reese-grimsley/ww-impedance-matching/ww-impedance-matching.brd

## EAGLE design ww-impedance-matching.brd (2021-09-02)

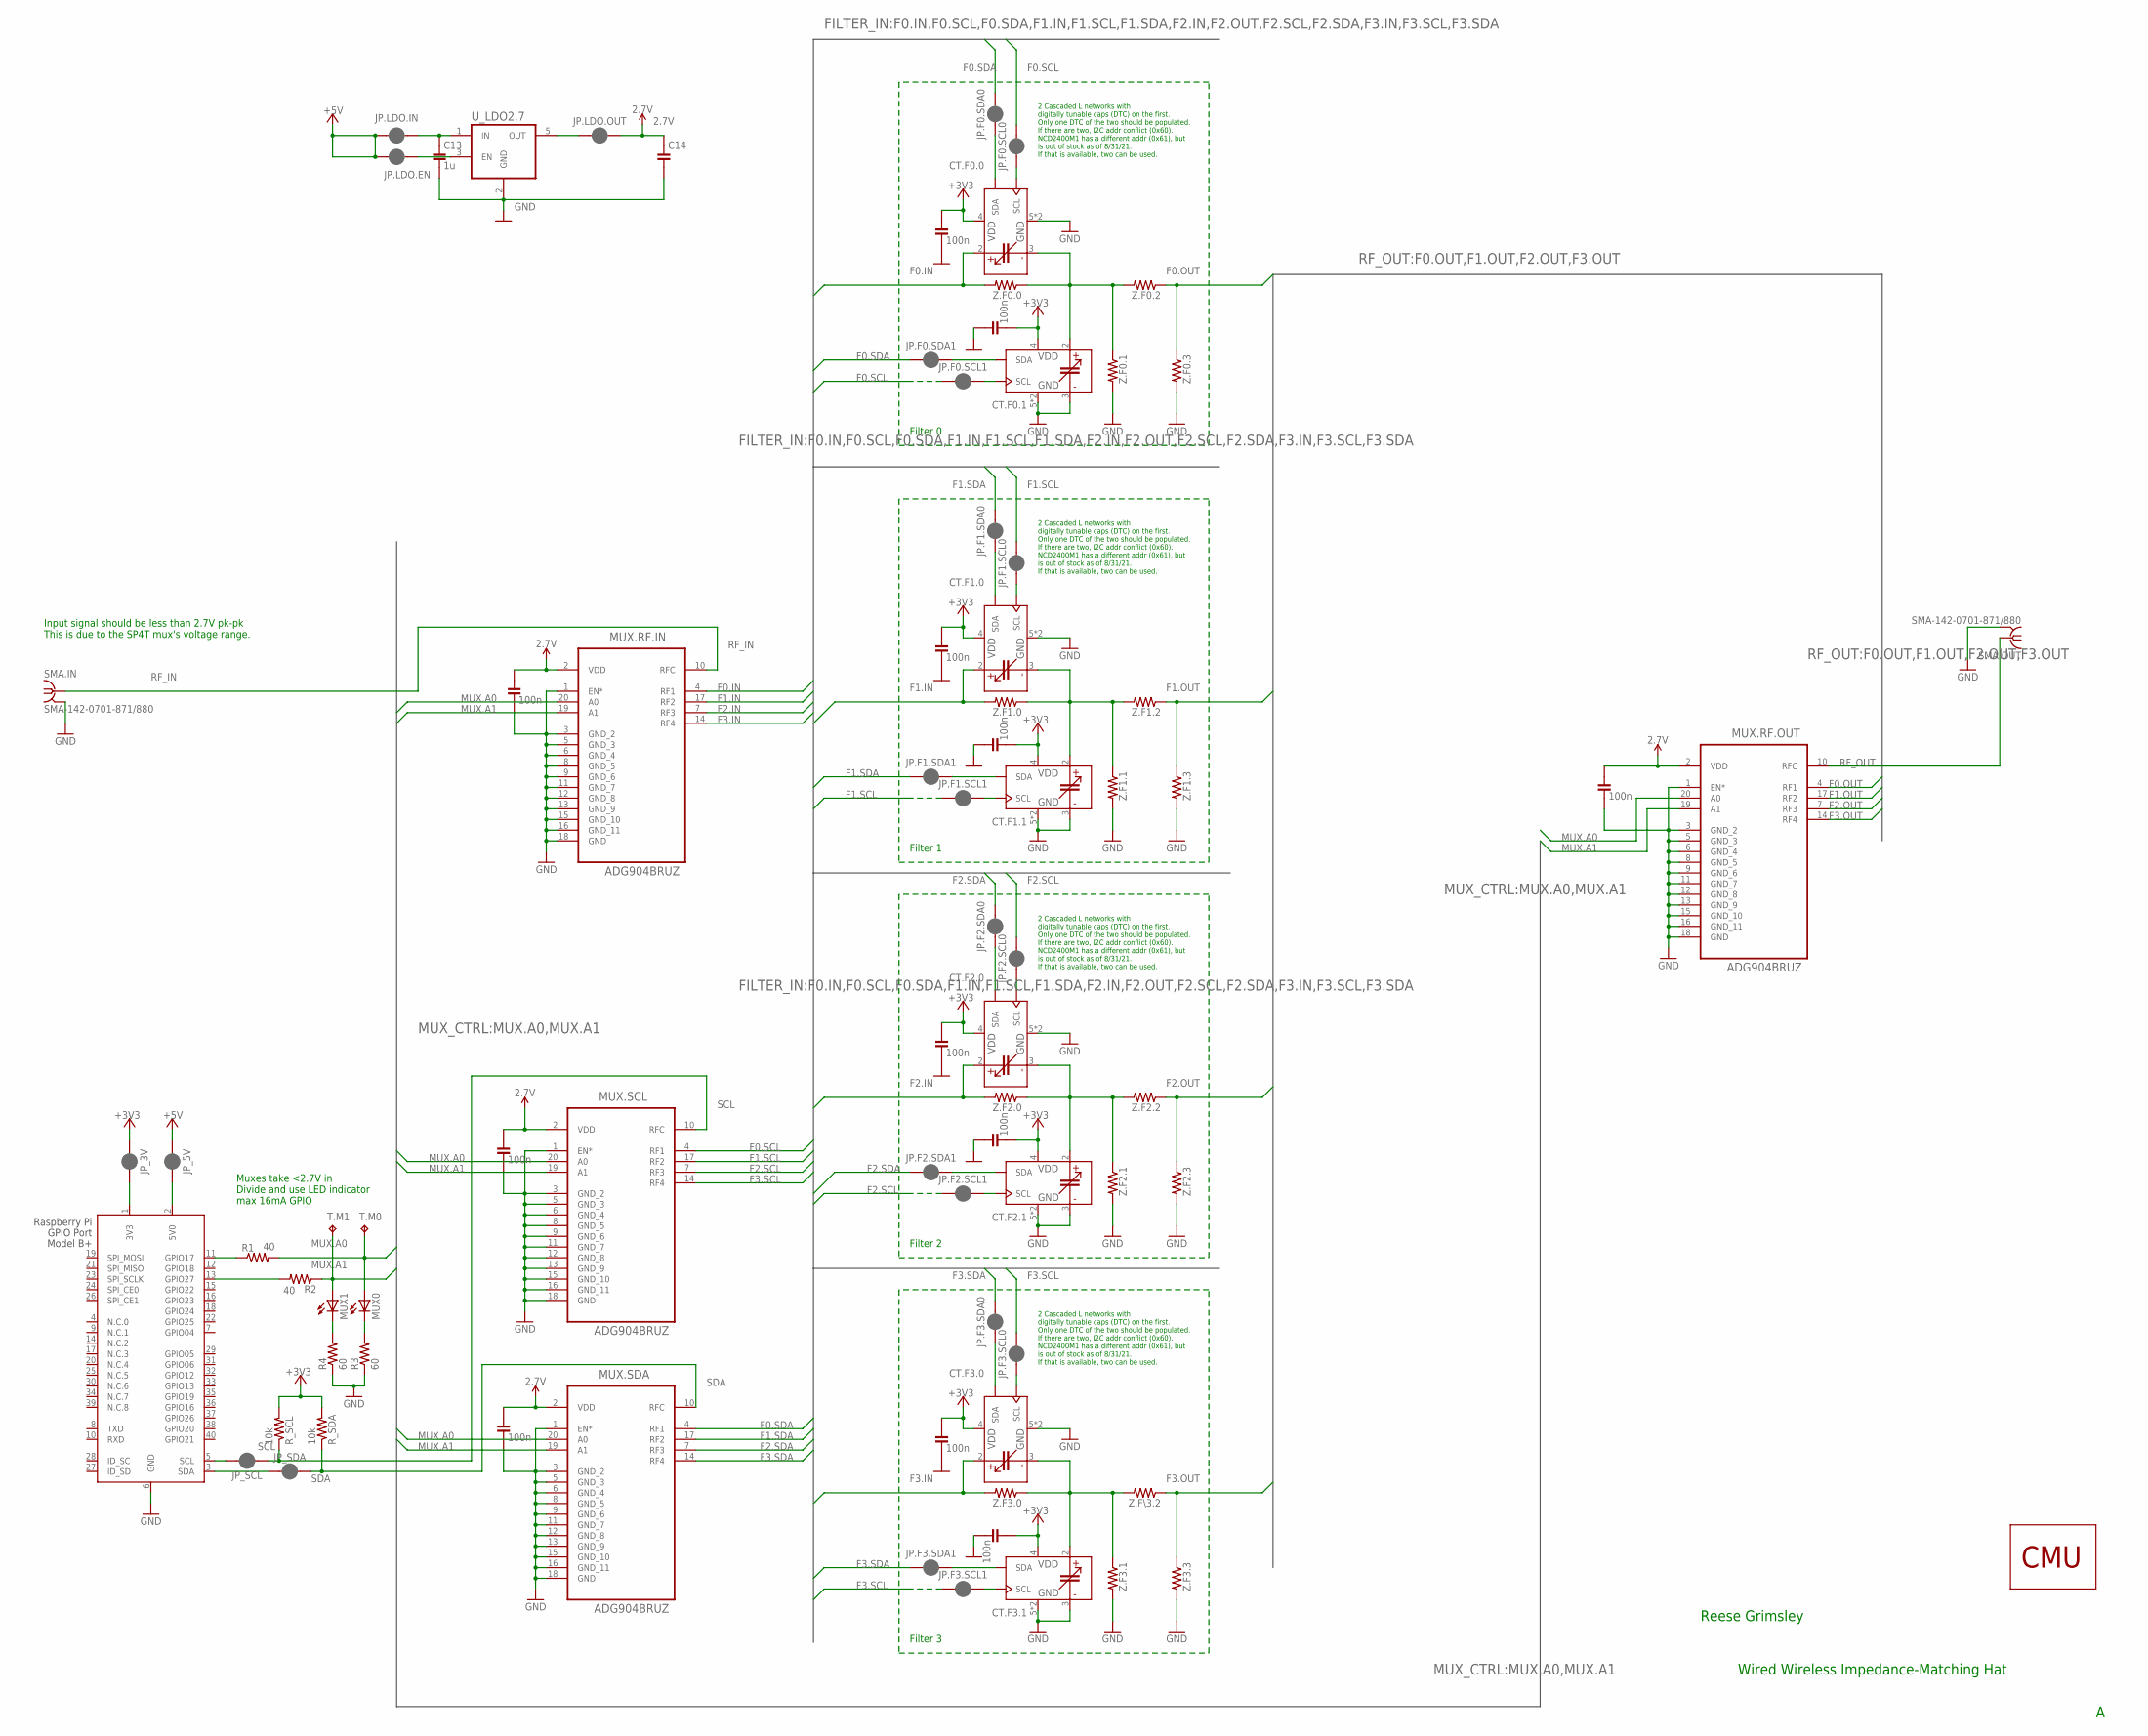
[picture p1: schematic ww-impedance-matching.sch]

Parts:
C1, C2, C3, C4, C5, C6, C7, C8, C9, C10, C11, C12: 100n; C0603; MPN CC0603MRX7R7BB104
C13: 1u; C0603; MPN CC0603MRX5R8BB105
C14: C-0805; C0805; MPN CC0805KPX5R6BB106
CT.F0.0, CT.F0.1, CT.F1.0, CT.F1.1, CT.F2.0, CT.F2.1, CT.F3.0, CT.F3.1: TUNABLE_CAP_NCD2400MTR; DFN-6_NCD2400M
JP.F0.SCL0, JP.F0.SCL1, JP.F0.SDA0, JP.F0.SDA1, JP.F1.SCL0, JP.F1.SCL1, JP.F1.SDA0, JP.F1.SDA1, JP.F2.SCL0, JP.F2.SCL1, JP.F2.SDA0, JP.F2.SDA1, JP.F3.SCL0, JP.F3.SCL1, JP.F3.SDA0, JP.F3.SDA1, JP.LDO.EN, JP.LDO.IN, JP.LDO.OUT: JUMPER-SMT_2_NC_PASTE_NO-SILK; SMT-JUMPER_2_NC_PASTE_NO-SILK
JP_3V, JP_5V: JUMPER-SMT_2_NC_PASTE_NO-SILK; SMT-JUMPER_2_NC_PASTE_NO-SILK
JP_SCL: JUMPER-SMT_2_NC_PASTE_NO-SILK; SMT-JUMPER_2_NC_PASTE_NO-SILK
JP_SDA: JUMPER-SMT_2_NC_PASTE_NO-SILK; SMT-JUMPER_2_NC_PASTE_NO-SILK
LOGO1: LOGO-CMU; CMU_LOGO
MUX0, MUX1: LEDCHIPLED_0603; CHIPLED_0603; MPN LSM0603412V
MUX.RF.IN, MUX.RF.OUT, MUX.SCL, MUX.SDA: ADG904BRUZ; SOP65P640X120-20N
R1, R2: 40; R0603; MPN ERJ-3EKF40R2V
R3, R4: 60; R0603; MPN ERJ-3EKF60R4V
R_SCL: 10k; R0603; MPN ERJ-PA3F1002V
R_SDA: 10k; R0603; MPN ERJ-PA3F1002V
SMA.IN, SMA.OUT: SMA-142-0701-871/880; SMA-142-0701-871; PART_NO 142-0701-871
T.M0, T.M1: TPTP14R; TP14R
U_LDO2.7: TPS76327DBVT; SOT95P280X145-5N; MPN TPS76327DBVT
X1: RASPI_BOARD_B+_E4P; RASPI_BOARD_B+_EDGES_4DRILL_PAD; MPN TSM-110-02-S-DV
Z.F0.0, Z.F0.1, Z.F0.2, Z.F0.3, Z.F1.0, Z.F1.1, Z.F1.2, Z.F1.3, Z.F2.0, Z.F2.1, Z.F2.2, Z.F2.3, Z.F3.0, Z.F3.1, Z.F3.3, Z.F\3.2: R-0603; R0603

Connections:
2.7V: C7.1, C9.1, C11.1, C12.1, C14.1, JP.LDO.OUT.1, MUX.RF.IN.2 (VDD), MUX.RF.OUT.2 (VDD), MUX.SCL.2 (VDD), MUX.SDA.2 (VDD)
3V3.JMP: JP_3V.1, X1.1 (3V3)
5V.JMP: JP_5V.1, X1.2 (5V0)
+3V3: C1.1, C2.2, C3.1, C4.1, C5.1, C6.2, C8.1, C10.2, CT.F0.0.4 (VDD), CT.F0.1.4 (VDD), CT.F1.0.4 (VDD), CT.F1.1.4 (VDD), CT.F2.0.4 (VDD), CT.F2.1.4 (VDD), CT.F3.0.4 (VDD), CT.F3.1.4 (VDD), JP_3V.2, R_SCL.2, R_SDA.2
+5V: JP.LDO.EN.2, JP.LDO.IN.2, JP_5V.2
F0.IN: CT.F0.0.2 (C+), MUX.RF.IN.4 (RF1), Z.F0.0.2
F0.OUT: MUX.RF.OUT.4 (RF1), Z.F0.2.1, Z.F0.3.1
F0.SCL: JP.F0.SCL0.1, JP.F0.SCL1.2, MUX.SCL.4 (RF1)
F0.SDA: JP.F0.SDA0.1, JP.F0.SDA1.2, MUX.SDA.4 (RF1)
F0SCL0: CT.F0.0.6 (SCL), JP.F0.SCL0.2
F0SCL1: CT.F0.1.6 (SCL), JP.F0.SCL1.1
F0SDA0: CT.F0.0.1 (SDA), JP.F0.SDA0.2
F0SDA1: CT.F0.1.1 (SDA), JP.F0.SDA1.1
F1.IN: CT.F1.0.2 (C+), MUX.RF.IN.17 (RF2), Z.F1.0.2
F1.OUT: MUX.RF.OUT.17 (RF2), Z.F1.2.1, Z.F1.3.1
F1.SCL: JP.F1.SCL0.1, JP.F1.SCL1.2, MUX.SCL.17 (RF2)
F1.SDA: JP.F1.SDA0.1, JP.F1.SDA1.2, MUX.SDA.17 (RF2)
F1SCL0: CT.F1.0.6 (SCL), JP.F1.SCL0.2
F1SCL1: CT.F1.1.6 (SCL), JP.F1.SCL1.1
F1SDA0: CT.F1.0.1 (SDA), JP.F1.SDA0.2
F1SDA1: CT.F1.1.1 (SDA), JP.F1.SDA1.1
F2.IN: CT.F2.0.2 (C+), MUX.RF.IN.7 (RF3), Z.F2.0.2
F2.OUT: MUX.RF.OUT.7 (RF3), Z.F2.2.1, Z.F2.3.1
F2.SCL: JP.F2.SCL0.1, JP.F2.SCL1.2, MUX.SCL.7 (RF3)
F2.SDA: JP.F2.SDA0.1, JP.F2.SDA1.2, MUX.SDA.7 (RF3)
F2SCL0: CT.F2.0.6 (SCL), JP.F2.SCL0.2
F2SCL1: CT.F2.1.6 (SCL), JP.F2.SCL1.1
F2SDA0: CT.F2.0.1 (SDA), JP.F2.SDA0.2
F2SDA1: CT.F2.1.1 (SDA), JP.F2.SDA1.1
F3.IN: CT.F3.0.2 (C+), MUX.RF.IN.14 (RF4), Z.F3.0.2
F3.OUT: MUX.RF.OUT.14 (RF4), Z.F3.3.1, Z.F\3.2.1
F3.SCL: JP.F3.SCL0.1, JP.F3.SCL1.2, MUX.SCL.14 (RF4)
F3.SDA: JP.F3.SDA0.1, JP.F3.SDA1.2, MUX.SDA.14 (RF4)
F3SCL0: CT.F3.0.6 (SCL), JP.F3.SCL0.2
F3SCL1: CT.F3.1.6 (SCL), JP.F3.SCL1.1
F3SDA0: CT.F3.0.1 (SDA), JP.F3.SDA0.2
F3SDA1: CT.F3.1.1 (SDA), JP.F3.SDA1.1
GND: C1.2, C2.1, C3.2, C4.2, C5.2, C6.1, C7.2, C8.2, C9.2, C10.1, C11.2, C12.2, C13.2, C14.2, CT.F0.0.5 (GND), CT.F0.0.7 (GND), CT.F0.1.3 (C-), CT.F0.1.5 (GND), CT.F0.1.7 (GND), CT.F1.0.5 (GND), CT.F1.0.7 (GND), CT.F1.1.3 (C-), CT.F1.1.5 (GND), CT.F1.1.7 (GND), CT.F2.0.5 (GND), CT.F2.0.7 (GND), CT.F2.1.3 (C-), CT.F2.1.5 (GND), CT.F2.1.7 (GND), CT.F3.0.5 (GND), CT.F3.0.7 (GND), CT.F3.1.3 (C-), CT.F3.1.5 (GND), CT.F3.1.7 (GND), MUX.RF.IN.1 (EN*), MUX.RF.IN.3 (GND_2), MUX.RF.IN.5 (GND_3), MUX.RF.IN.6 (GND_4), MUX.RF.IN.8 (GND_5), MUX.RF.IN.9 (GND_6), MUX.RF.IN.11 (GND_7), MUX.RF.IN.12 (GND_8), MUX.RF.IN.13 (GND_9), MUX.RF.IN.15 (GND_10), MUX.RF.IN.16 (GND_11), MUX.RF.IN.18 (GND), MUX.RF.OUT.1 (EN*), MUX.RF.OUT.3 (GND_2), MUX.RF.OUT.5 (GND_3), MUX.RF.OUT.6 (GND_4), MUX.RF.OUT.8 (GND_5), MUX.RF.OUT.9 (GND_6), MUX.RF.OUT.11 (GND_7), MUX.RF.OUT.12 (GND_8), MUX.RF.OUT.13 (GND_9), MUX.RF.OUT.15 (GND_10), MUX.RF.OUT.16 (GND_11), MUX.RF.OUT.18 (GND), MUX.SCL.1 (EN*), MUX.SCL.3 (GND_2), MUX.SCL.5 (GND_3), MUX.SCL.6 (GND_4), MUX.SCL.8 (GND_5), MUX.SCL.9 (GND_6), MUX.SCL.11 (GND_7), MUX.SCL.12 (GND_8), MUX.SCL.13 (GND_9), MUX.SCL.15 (GND_10), MUX.SCL.16 (GND_11), MUX.SCL.18 (GND), MUX.SDA.1 (EN*), MUX.SDA.3 (GND_2), MUX.SDA.5 (GND_3), MUX.SDA.6 (GND_4), MUX.SDA.8 (GND_5), MUX.SDA.9 (GND_6), MUX.SDA.11 (GND_7), MUX.SDA.12 (GND_8), MUX.SDA.13 (GND_9), MUX.SDA.15 (GND_10), MUX.SDA.16 (GND_11), MUX.SDA.18 (GND), R3.1, R4.1, SMA.IN.2@1 (2), SMA.IN.2@2 (2), SMA.IN.2@3 (2), SMA.IN.2@4 (2), SMA.OUT.2@1 (2), SMA.OUT.2@2 (2), SMA.OUT.2@3 (2), SMA.OUT.2@4 (2), U_LDO2.7.2 (GND), X1.6 (GND), Z.F0.1.2, Z.F0.3.2, Z.F1.1.2, Z.F1.3.2, Z.F2.1.2, Z.F2.3.2, Z.F3.1.2, Z.F3.3.2
LDO.IN: C13.1, JP.LDO.IN.1, U_LDO2.7.1 (IN)
LDO.OUT: JP.LDO.OUT.2, U_LDO2.7.5 (OUT)
MUX.A0: MUX0.A, MUX.RF.IN.20 (A0), MUX.RF.OUT.20 (A0), MUX.SCL.20 (A0), MUX.SDA.20 (A0), R1.2, T.M0.TP
MUX.A1: MUX1.A, MUX.RF.IN.19 (A1), MUX.RF.OUT.19 (A1), MUX.SCL.19 (A1), MUX.SDA.19 (A1), R2.1, T.M1.TP
unnamed: MUX1.C, R4.2
unnamed: JP.LDO.EN.1, U_LDO2.7.3 (EN)
unnamed: MUX0.C, R3.2
unnamed: R2.2, X1.13 (GPIO27)
unnamed: R1.1, X1.11 (GPIO17)
RF.F0.0: CT.F0.0.3 (C-), CT.F0.1.2 (C+), Z.F0.0.1, Z.F0.1.1, Z.F0.2.2
RF.F1.0: CT.F1.0.3 (C-), CT.F1.1.2 (C+), Z.F1.0.1, Z.F1.1.1, Z.F1.2.2
RF.F2.0: CT.F2.0.3 (C-), CT.F2.1.2 (C+), Z.F2.0.1, Z.F2.1.1, Z.F2.2.2
RF.F3.0: CT.F3.0.3 (C-), CT.F3.1.2 (C+), Z.F3.0.1, Z.F3.1.1, Z.F\3.2.2
RF_IN: MUX.RF.IN.10 (RFC), SMA.IN.1
RF_OUT: MUX.RF.OUT.10 (RFC), SMA.OUT.1
SCL: JP_SCL.2, MUX.SCL.10 (RFC), R_SCL.1
SCL.IN: JP_SCL.1, X1.5 (SCL)
SDA: JP_SDA.1, MUX.SDA.10 (RFC), R_SDA.1
SDA.IN: JP_SDA.2, X1.3 (SDA)

Notes on the sheet:
Wired Wireless Impedance-Matching Hat
Filter 0
2 Cascaded L networks with digitally tunable caps (DTC) on the first. Only one DTC of the two should be populated. If there are two, I2C addr conflict (0x60). NCD2400M1 has a different addr (0x61), but is out of stock as of 8/31/21. If that is available, two can be used.
Filter 1
Filter 2
Reese Grimsley
Filter 3
Muxes take <2.7V in Divide and use LED indicator max 16mA GPIO
Input signal should be less than 2.7V pk-pk This is due to the SP4T mux's voltage range.

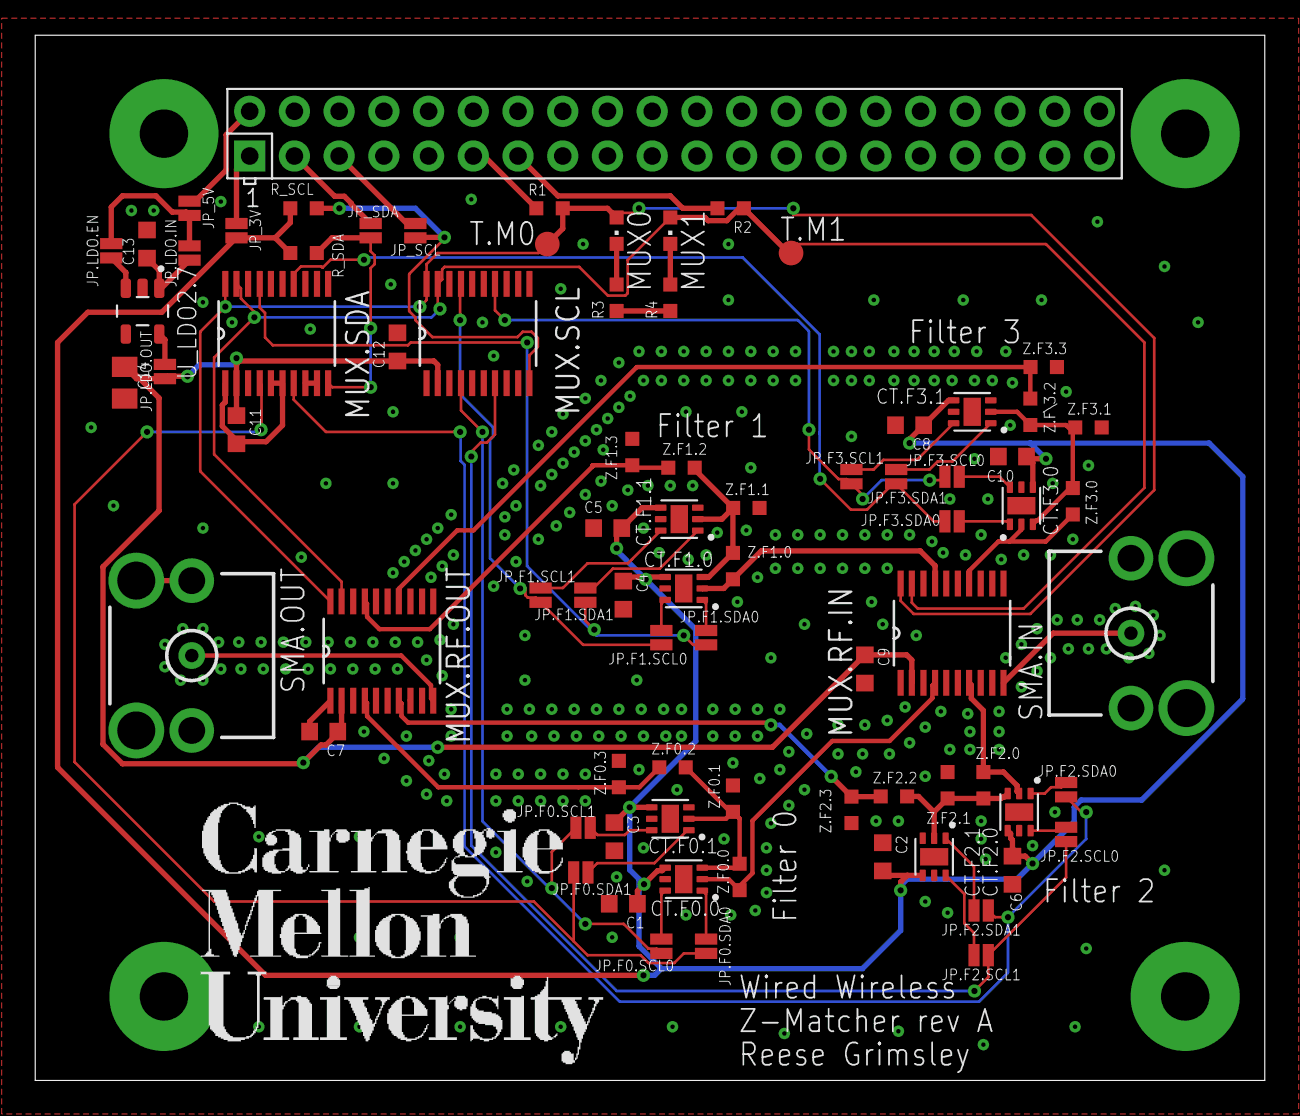
[picture p2: board ww-impedance-matching.brd from above]

Board: 2 copper layers, 69.8 x 59.4 mm, 80 parts (0 on the bottom side), 57 nets.
