reese-grimsley/ww-impedance-matching/ww-impedance-matching-circuit.brd

## EAGLE design ww-impedance-matching-circuit.brd (2021-09-01)

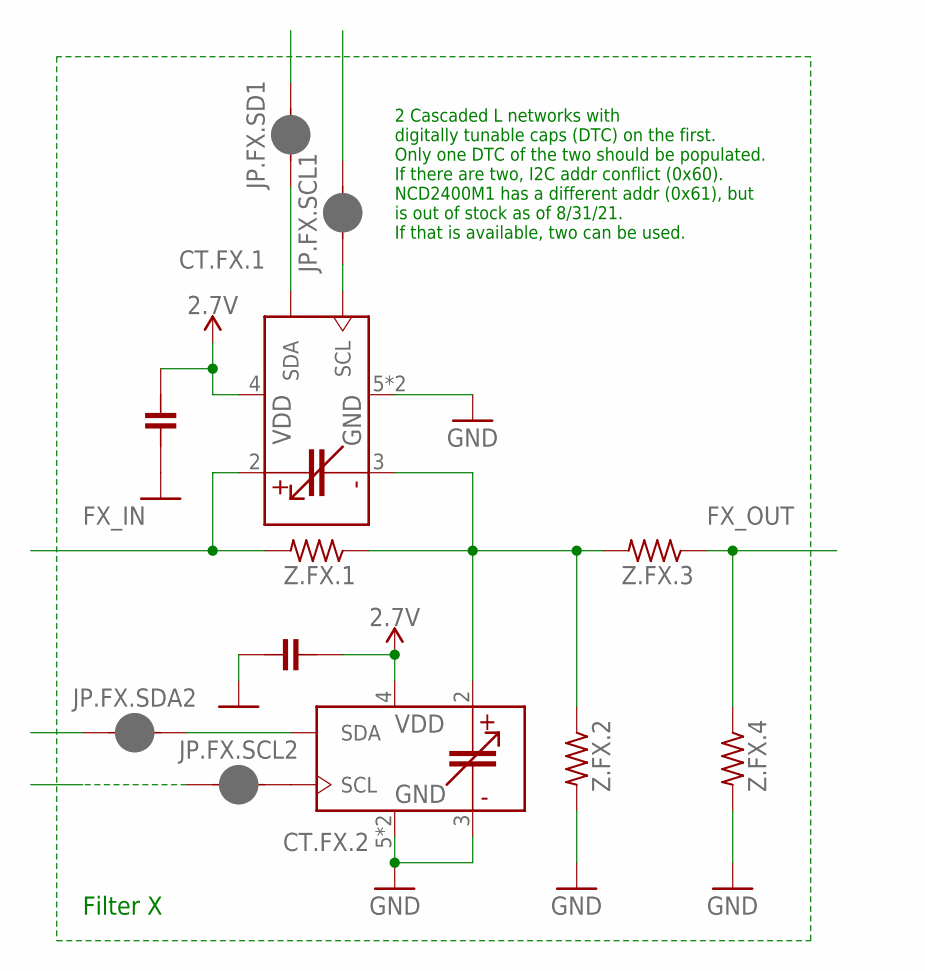
[picture p3: schematic ww-impedance-matching-circuit.sch]

Parts:
C1, C2: C-0603; C0603
CT.FX.1, CT.FX.2: TUNABLE_CAP_NCD2400MTR; DFN-6_NCD2400M
JP.FX.SCL1, JP.FX.SCL2, JP.FX.SD1, JP.FX.SDA2: JUMPER-SMT_2_NC_PASTE_NO-SILK; SMT-JUMPER_2_NC_PASTE_NO-SILK
Z.FX.1, Z.FX.2, Z.FX.3, Z.FX.4: R-0603; R0603

Connections:
2.7V: C1.1, C2.1, CT.FX.1.4 (VDD), CT.FX.2.4 (VDD)
FX_IN: CT.FX.1.2 (C+), Z.FX.1.2
FX_OUT: Z.FX.3.1, Z.FX.4.1
GND: C1.2, C2.2, CT.FX.1.5 (GND), CT.FX.1.7 (GND), CT.FX.2.3 (C-), CT.FX.2.5 (GND), CT.FX.2.7 (GND), Z.FX.2.2, Z.FX.4.2
unnamed: CT.FX.1.3 (C-), CT.FX.2.2 (C+), Z.FX.1.1, Z.FX.2.1, Z.FX.3.2
unnamed: CT.FX.1.1 (SDA), JP.FX.SD1.2
unnamed: CT.FX.2.1 (SDA), JP.FX.SDA2.1
unnamed: CT.FX.2.6 (SCL), JP.FX.SCL2.1
unnamed: CT.FX.1.6 (SCL), JP.FX.SCL1.2

Notes on the sheet:
Filter X
2 Cascaded L networks with digitally tunable caps (DTC) on the first. Only one DTC of the two should be populated. If there are two, I2C addr conflict (0x60). NCD2400M1 has a different addr (0x61), but is out of stock as of 8/31/21. If that is available, two can be used.

Board: 2 copper layers, 12 parts (0 on the bottom side), 9 nets, no tracks yet.
