reese-grimsley/ww-impedance-matching/(commit log)

2021-09-01 first pass schematic
    [ww-impedance-matching-circuit.brd, ww-impedance-matching-circuit.sch, ww-impedance-matching.brd, ww-impedance-matching.sch]
2021-09-01 schematic done, basic component placement
    [ww-impedance-matching.brd, ww-impedance-matching.sch]
2021-09-01 filter placement
    [ww-impedance-matching.brd, ww-impedance-matching.sch]
2021-09-01 mostly routed
    [ww-impedance-matching.brd, ww-impedance-matching.sch]
2021-09-01 routed and passed DRC
    [ww-impedance-matching.brd]
2021-09-01 ready to submit rev A for production
    [ww-impedance-matching.brd]
2021-09-01 add BOM
    [BOM_ww-filterbank.xlsx, ww-impedance-matching.brd, ww-impedance-matching.sch]
2021-09-02 revA production
    [copper_bottom.gbr, copper_top.gbr, drill_1_16.xln, gerber_job.gbrjob, profile.gbr, silkscreen_bottom.gbr, silkscreen_top.gbr, soldermask_bottom.gbr]
2021-09-11 i2c to caps
